kkredit/Senior_Design_Team_16/README.md

# senior-design-team-16
The code for my senior design project, GardeNet, an IoT garden watering automation system.
To anyone looking through the history, apologies for the poor workflow. Our team was learning how to use git along the way.
