kkredit/Senior_Design_Team_16/Team16Website/garden_net/gn_util/garden_info.txt

{"Garden":{"openZones":"3"},"Zone1":{"name":"Planter Boxes","weather":"Full","node":"1","valve":"1","openevents":"3"},"Zone2":{"name":"Planter Boxes 2","weather":"Partial","node":"1","valve":"2","openevents":"3"},"Zone3":{"name":"Field","weather":"None","node":"1","valve":"3","openevents":"3"},"Zone4":{"name":"New Zone","node":"3","valve":"4","weather":"None","openevents":"8"}}
