kkredit/Senior_Design_Team_16/Team16Website/Documents/OralPresentation3.pdf

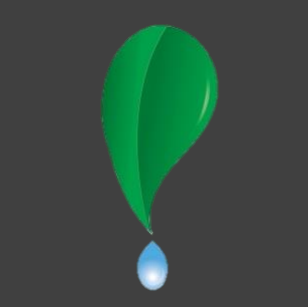
[picture p1: figure]

# GardeNet

# T EAM 1 6

# JOHN CONNELL, ANTHONY JIN, CHARLES KINGSTON, AND KEVIN KREDIT

# The Team

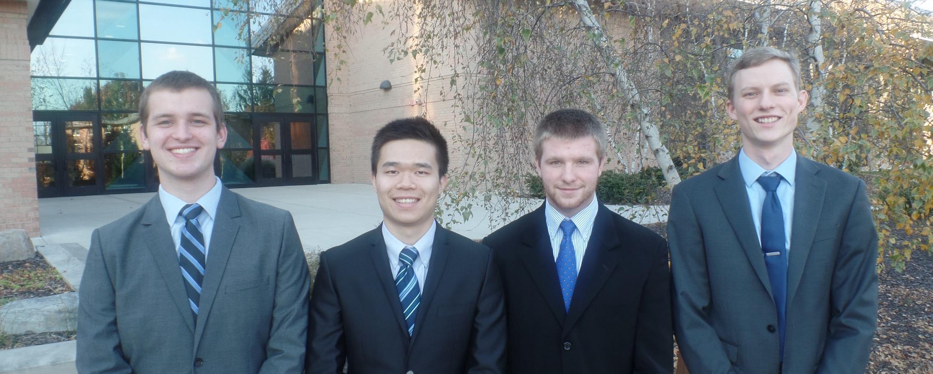
[picture p2: figure]

## John Connell | Anthony Jin | Charles Kingston | Kevin Kredit

# Overview

# ☐ The Project

# ☐ Design Decisions

# ☐ Project Highlights

# ☐ Current Status

The Project

# The Project

# The Problem

## ☐ Watering is a labor intensive venture ☐ Community gardens often have difficulties to get consistent volunteer help

# Our Solution

## ☐ Automate the watering process via

## ☐ 3G cellular network

## ☐ Internet-of-Things (IoT)

## ☐ Our main client is Caledonia Community Garden

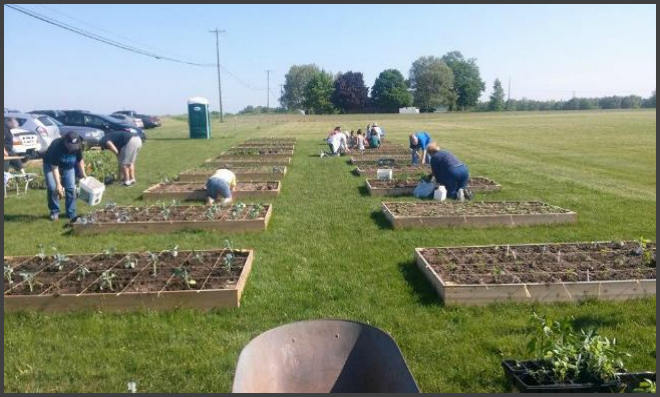
[picture p3: figure]

https://lintvwotv.files.wordpress.com/2014/06/maranda-caledonia-community-garden.jpg?w=650

## Caledonia Community Garden

The Project

# Our Design

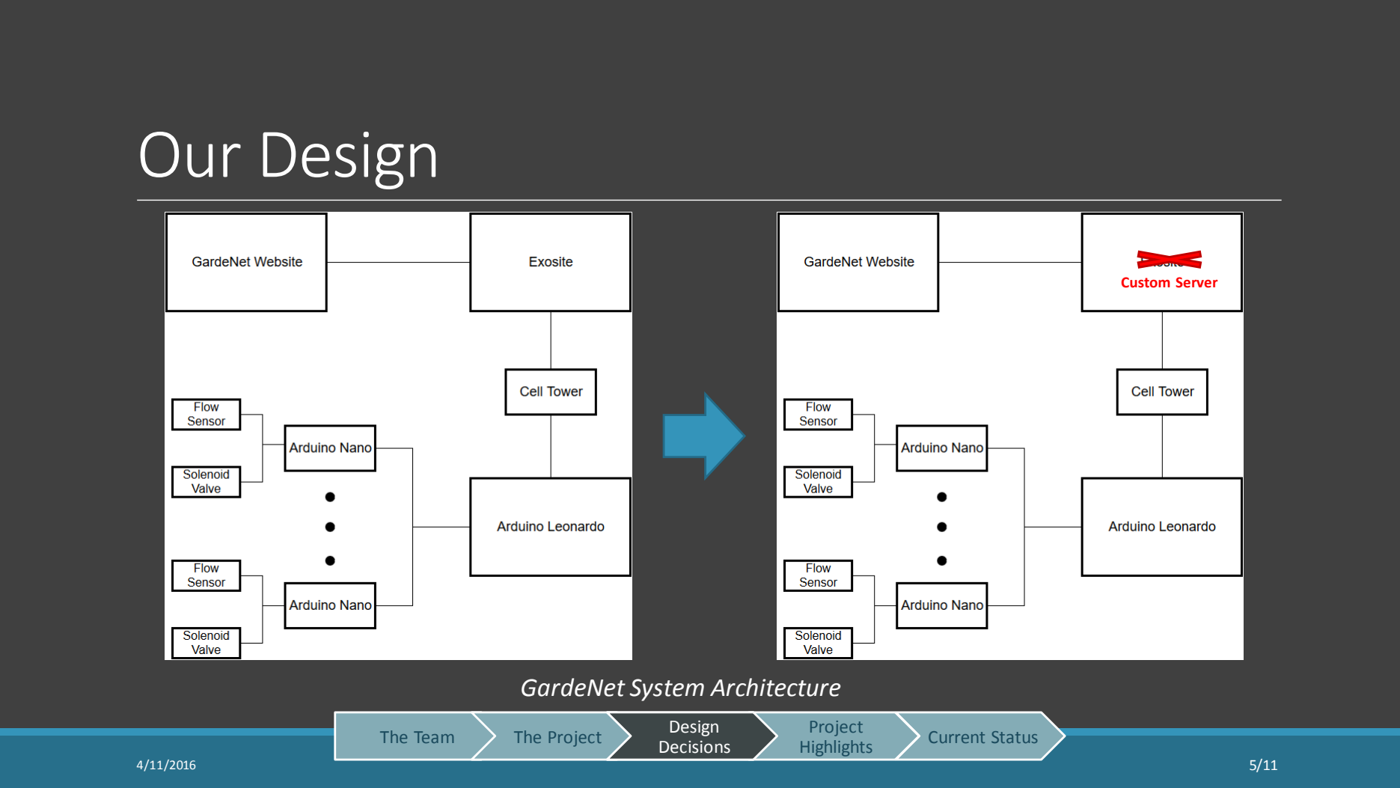
[picture p4: page 5]

Design
Decisions

## GardeNet System Architecture

Custom Server

# Hardware & Mesh Network

# ☐ Controlling valves ☐ Reading flow rates ☐ Communicating with the gateway ☐ Stability and PCB design

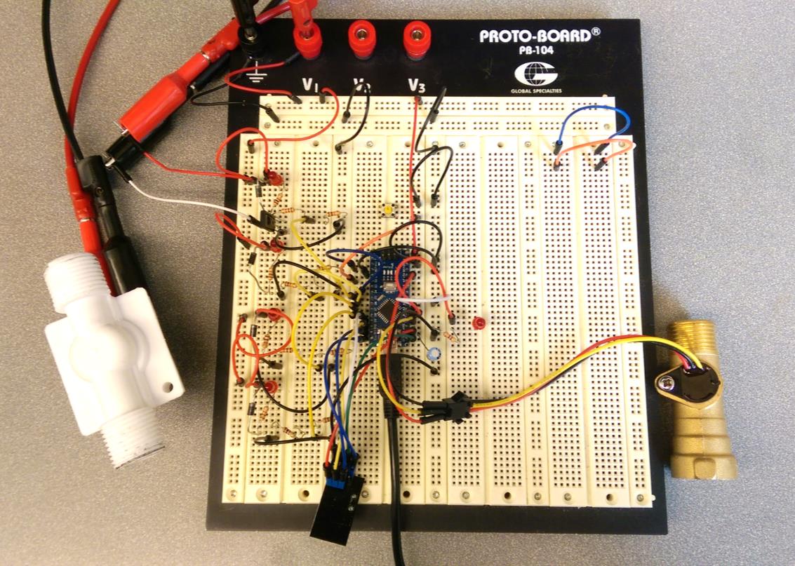
[picture p5: figure]

## The Node Breadboard

# Gateway & Arduino Shields

# ☐ Activated the 3G modem ☐ Added another shield ☐ Currently integrating 3G and radio communications

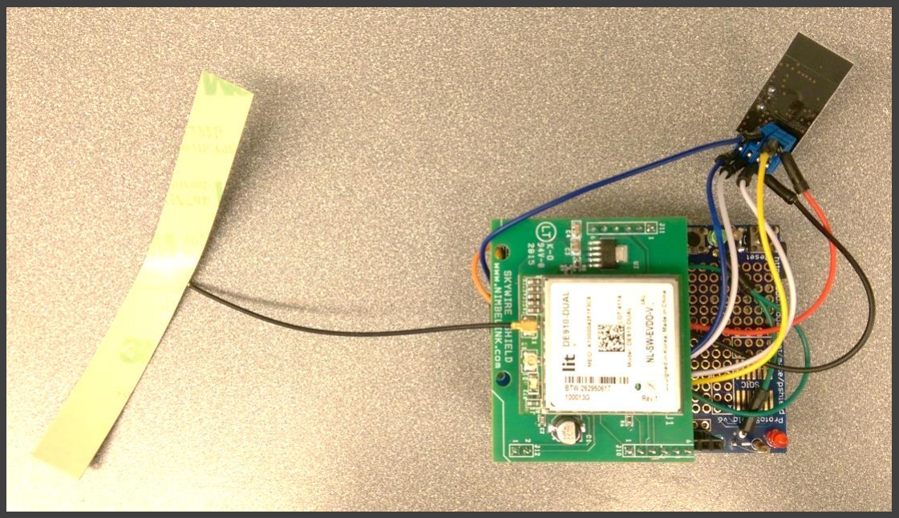
[picture p6: figure]
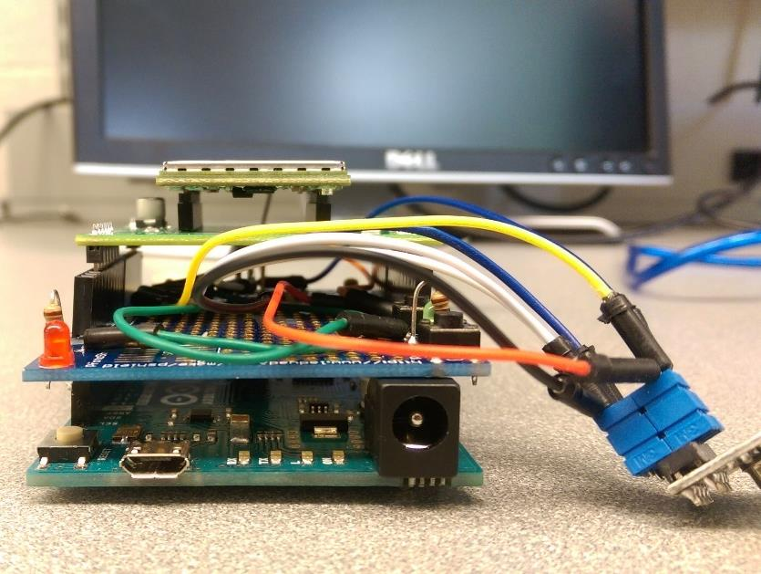
[picture p7: figure]

## The Gateway

# Server & Database

# ☐ Python scripts ☐ Hosted on a Raspberry Pi ☐ Interface & utilities ☐ Database

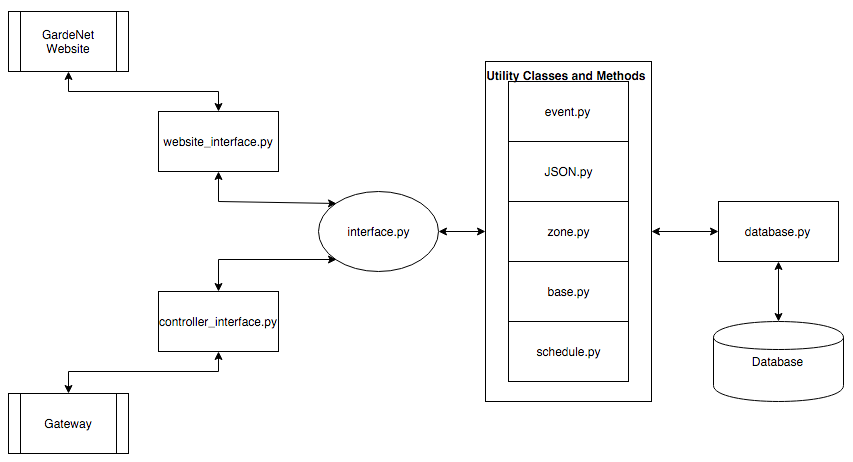
[picture p8: figure]

## GardeNet Server Architecture

# Website (gardenet.ddns.net)

# ☐ Schedules and switches ☐ Dynamically add zones and events ☐ Password protection ☐ “Live” on Raspberry Pi ☐ Dynamic DNS ☐ Future: Administrator View and Guest View

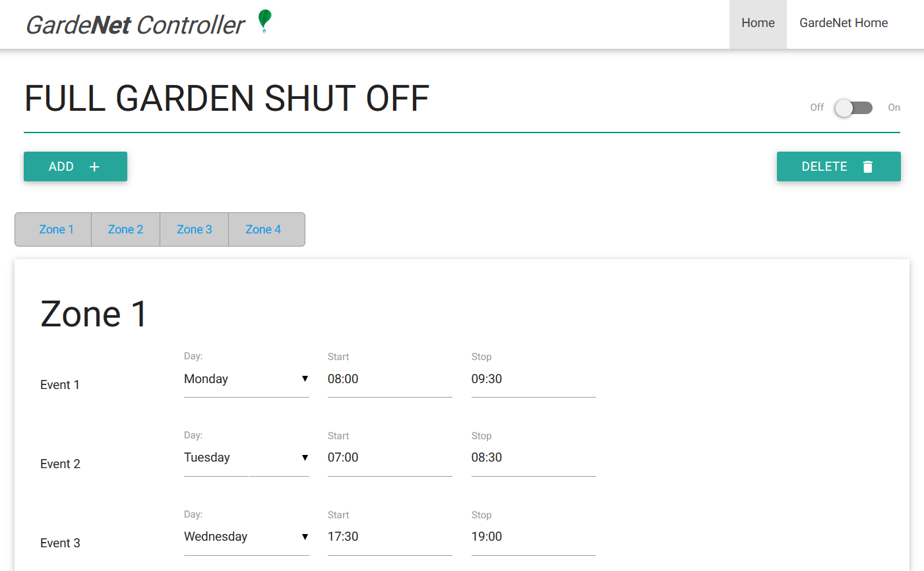
[picture p9: figure]

## GardeNet Controller

# Project Highlights

# Challenges

# ☐ Exosite vs. GardeNet server ☐ Budget & time constraints

# Opportunities

# ☐ Advice from experts ☐ Most important design norm: Trust

Project

# Current Status

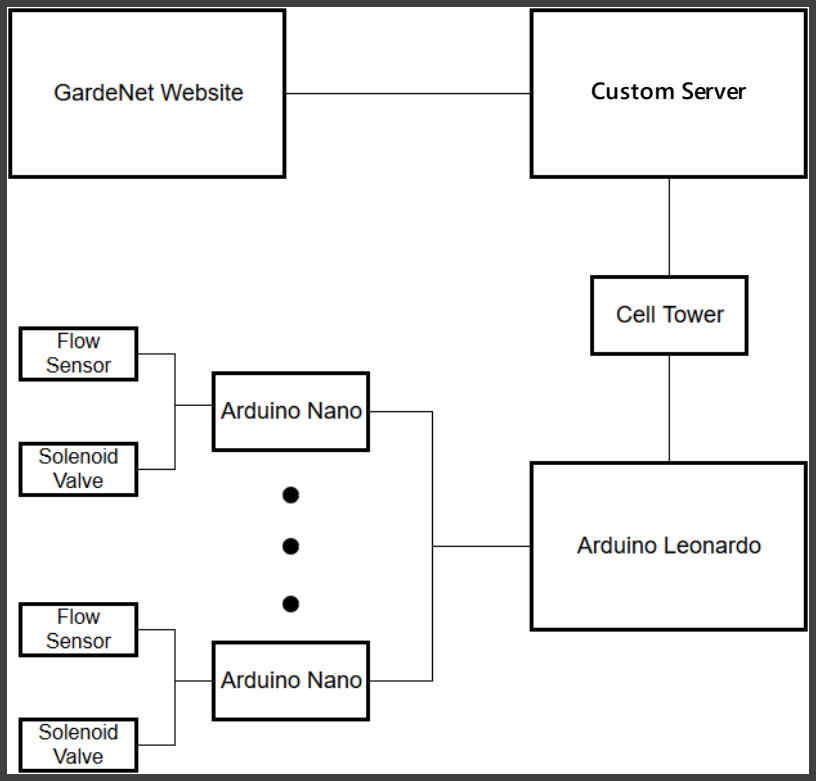
[picture p10: figure]
Custom Server

# ☐ Hardware & Mesh Network ☑

# ☐ Gateway

## ☐ Mesh network, 3G cell connection, internal timer ☑ ☐ Communication with server, scheduling algorithm ☒

## ☐ Server & Database

## ☐ Utilities and database ☑ ☐ Interfaces, process weather information ☒

# ☐ Website

## ☐ Basic UI and functionalities ☑ ☐ Dynamic zone size, message passing ☒

Current Status

4/11/2016

# Questions?
