kkredit/Senior_Design_Team_16/Team16Website/Documents/Team16FinalPresentation.pdf

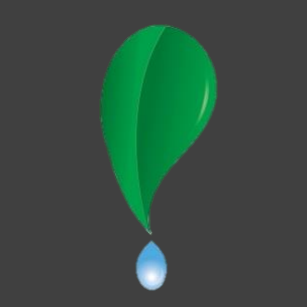
[picture p21: figure]

# GardeNet

### TEAM 16

### JOHN CONNELL, ANTHONY JIN, CHARLES KINGSTON, AND KEVIN KREDIT

# The Team


John Connell | Anthony Jin | Charles Kingston | Kevin Kredit

The Team | The Project | Design
Decisions | Reflections Project

# Overview

## ☐ The Project

## ☐ Design Decisions

## ☐ Project Highlights

## ☐ Reflections

The Project

The Team | The Project | Design

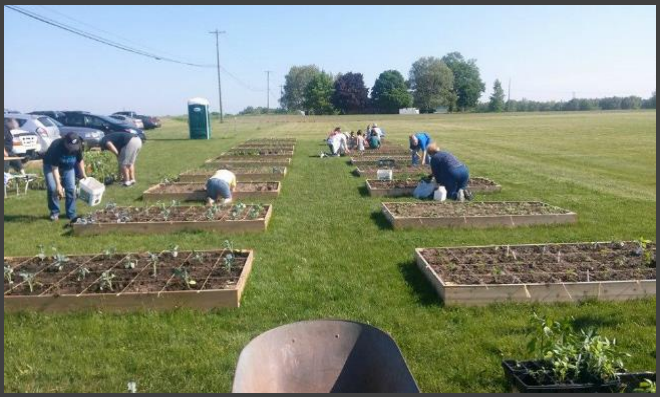
[picture p22: figure]

Decisions | Reflections Project

# The Project

### The Problem

☐ Watering is a labor intensive venture
☐ Community gardens often have difficulties to get consistent volunteer help

### Our Solution

☐ Automate the watering process via
☐ 3G cellular network
☐ Internet-of-Things (IoT)

### Target Market

☐ Urban farms to community and home gardens ☐ Our main client is Caledonia Community Garden https://lintvwotv.files.wordpress.com/2014/06/maranda-caledonia-community-garden.jpg?w=650

Caledonia Community Garden

The Project

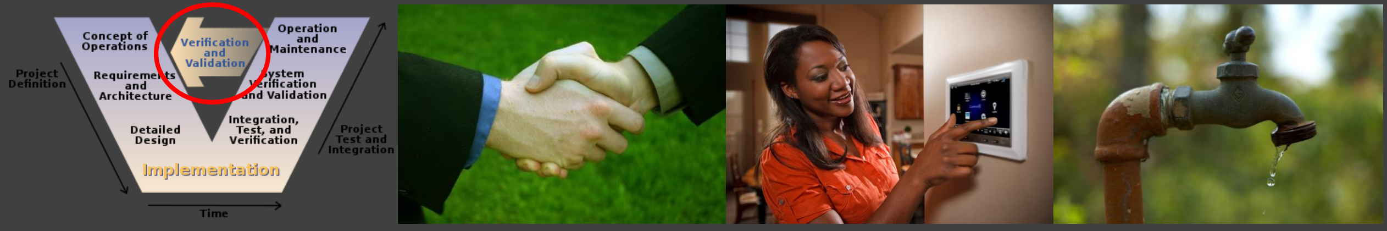
[picture p23: figure]

The Team | The Project | Design
Decisions | Reflections Project

# Design Norms

☐ Integrity | ☐ Trust | ☐ Humility | ☐ Stewardship

https://upload.wikimedia.org/wikipedia/commons/thumb/e/e8/Systems_Engineering_Process_II.svg/420px-Systems_Engineering_Process_II.svg.pnghttp://www.profitguide.com/w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

http://g4.imgdpreview.com/384DA42DD7B54A149394C67164F2AD16.jpg

The Project

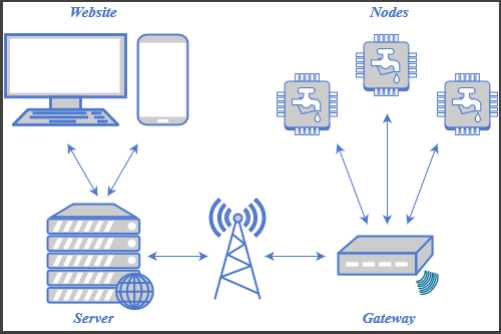
[picture p24: figure]

The Team | The Project | Design
Decisions | Reflections Project

# Our Design

Design
Decisions

Simplified GardeNet System Architecture

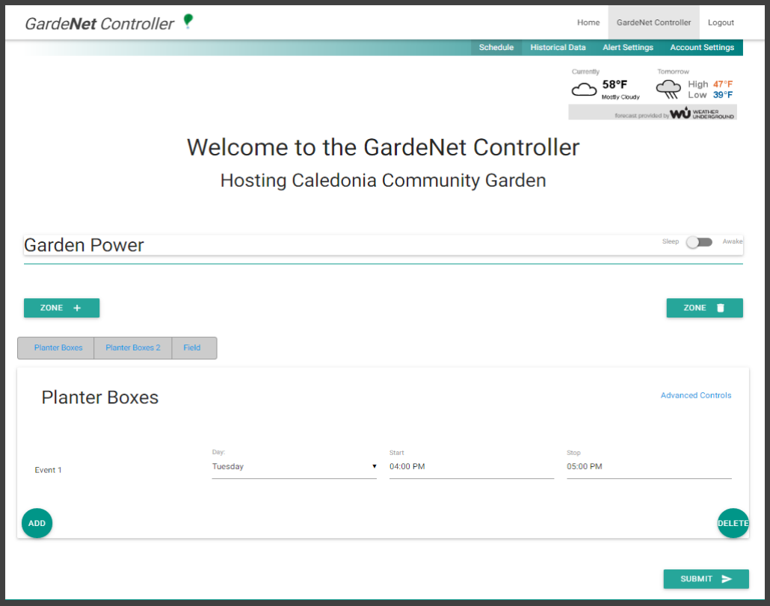
[picture p25: figure]

The Team | The Project | Design
Decisions | Reflections Project

# Website

Design
Decisions

### ☐ Platform: Apache web server on Raspberry Pi ☐ Features

☐ Dynamic scheduling
☐ Set weather sensitivity per zone
☐ “Public” and password
protected “Admin” views
☐ View historical data
☐ Modify alert and account settings

GardeNet Website

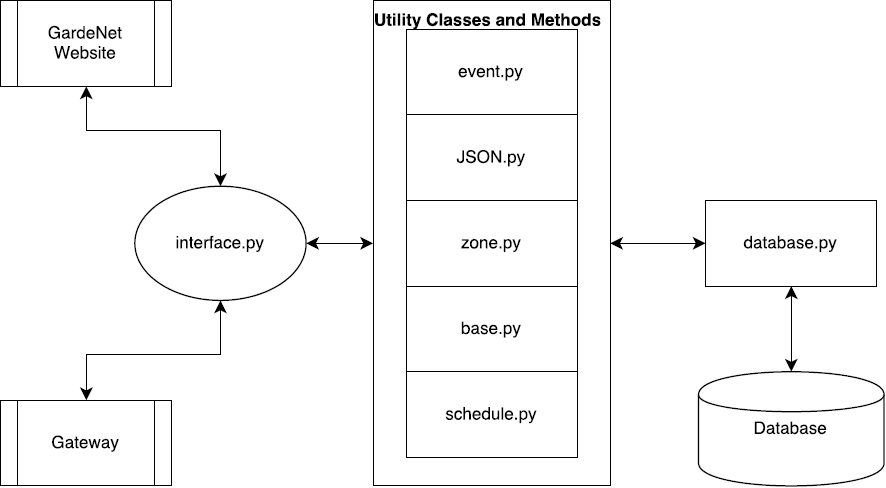
[picture p26: figure]

The Team | The Project | Design
Decisions | Reflections Project

# Server

### ☐ Platform: Python server on Raspberry Pi ☐ Communication: Internet sockets ☐ Controls

☐ Communication between the website and the gateway
☐ Historical data

### ☐ Monitors

☐ Weather
☐ Garden status, sends alerts

Design
Decisions

GardeNet Server Architecture

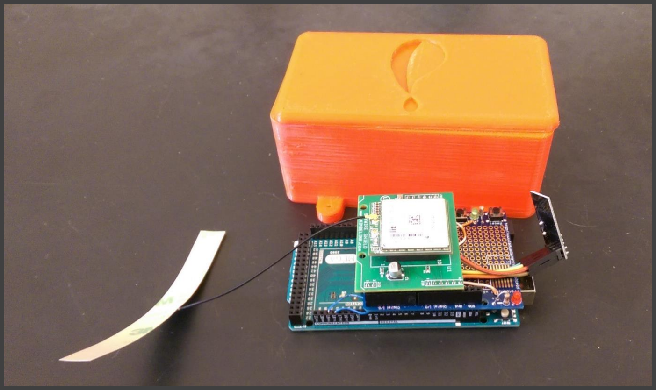
[picture p27: figure]

The Team | The Project | Design
Decisions | Reflections Project

# Gateway

### ☐ Platform: Arduino Leonardo / MEGA 2560 ☐ Communication

☐ 3G Modem
☐ RF24 radio

### ☐ Controls

☐ Nodes
☐ Alerts

### ☐ Monitors

☐ System feedback data

Design
Decisions

The Gateway

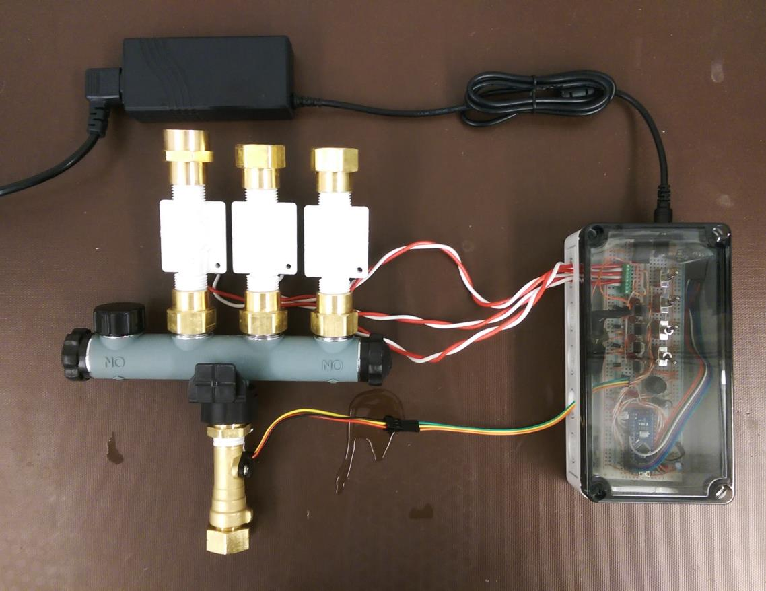
[picture p28: figure]

The Team | The Project | Design
Decisions | Reflections Project

# Node

### ☐ Platform: Arduino Nano ☐ Communication: RF24 radio ☐ Controls

☐ 4 valves
☐ 1 flow rate meter

### ☐ Monitors

☐ Input voltage level
☐ Flow states
☐ Communication link

### ☐ Modular

☐ Up to 16 nodes
☐ All programmed with same code

Design
Decisions

The Node

# Direct Control Video

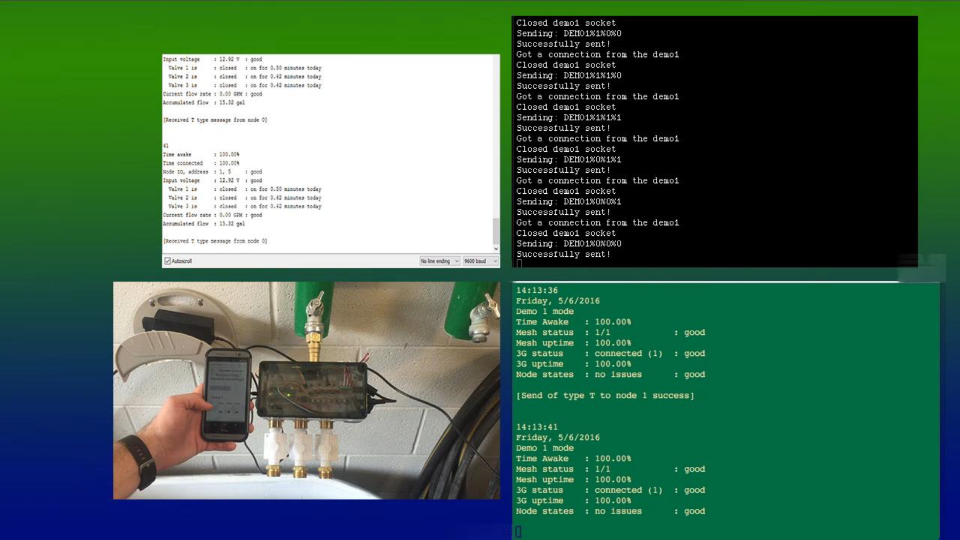
[picture p29: page 11]

The Team | The Project | Design
Decisions | Reflections Project

Project

# Schedule Video

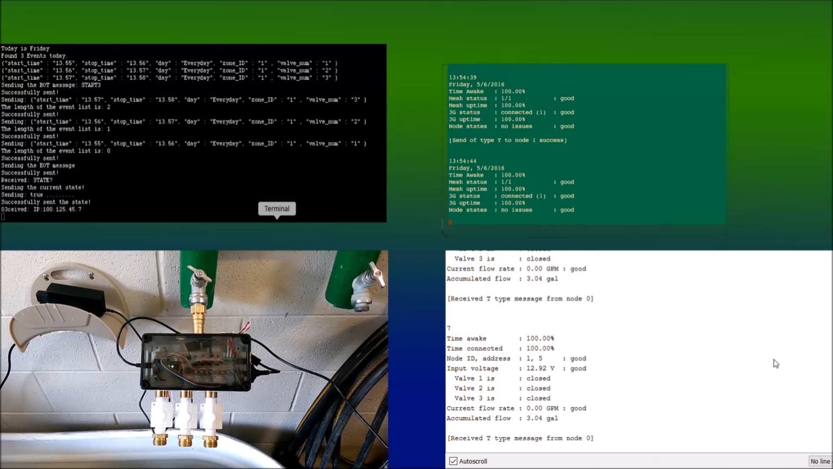
[picture p30: page 12]

The Team | The Project | Design
Decisions | Reflections Project

Project

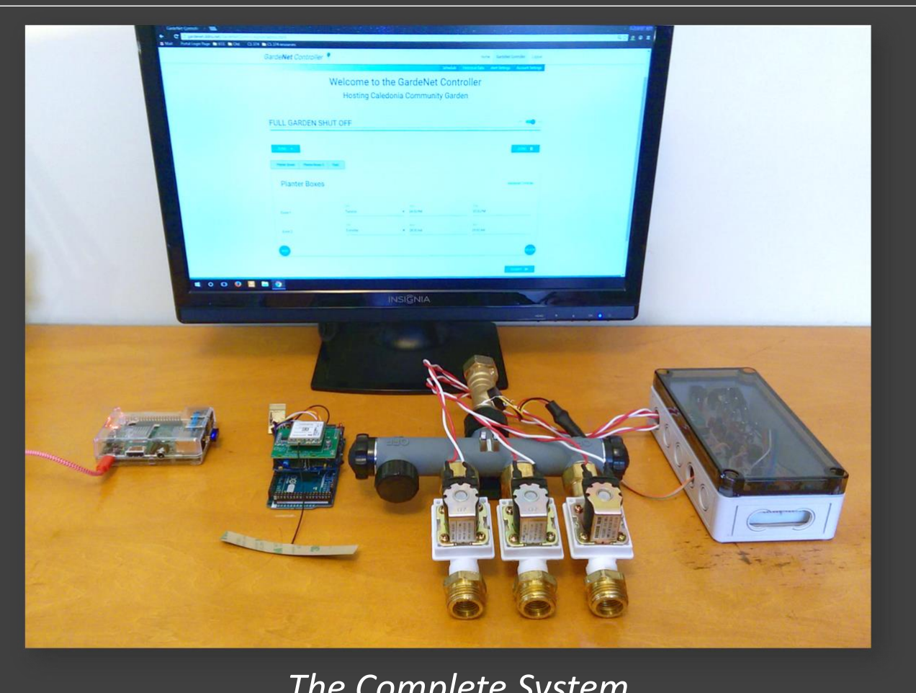
[picture p31: figure]

The Team | The Project | Design
Decisions | Reflections Project

# Project Highlights

## Challenges

### ☐ Seven programming languages ☐ Exosite vs. GardeNet server ☐ Reliability ☐ Budget and time constraints

## Opportunities

### ☐ Advice from experts ☐ Learning curve

Project

The Complete System

The Team | The Project | Design
Decisions | Reflections Project

# Assessment

Reflections

## What We Learned

### ☐ Systems design ☐ Web development ☐ Networking

## Future Work

### ☐ Better onsite control ☐ Onsite weather monitoring ☐ Control lights, outlets ☐ Dedicated mobile app ☐ Support multiple customers

The Complete System

The Team | The Project | Design
Decisions | Reflections Project

# Thanks

Reflections

Engineering Advisors ☐ Professor Mark Michmerhuizen ☐ Mentor Kurt Dykema ☐ Consultant Eric Walstra

Networking Advisors ☐ Professor Victor Norman ☐ Lab Administrator Chris Wieringa

Garden Managers ☐ David Benjamin of CCG ☐ Kyle Van Eerden of EDF

Engineering Support ☐ Bob DeKraker ☐ Phil Jasperse

5/17/2016

# Questions
