kkredit/Senior_Design_Team_16/Team16Website/garden_net/test/test_input.txt

{"zone1":
	{"event0":
		{"start_time" : "01:00", "stop_time" : "02:00", "day" : "Monday", "zone_ID" : "3" , "valve_num" : "1"},
	"event1":
		{"start_time" : "01:50", "stop_time" : "02:50", "day" : "Tuesday", "zone_ID" : "3" , "valve_num" : "1"},
	"event2":
		{"start_time" : "02:00", "stop_time" : "03.00", "day" : "Wednesday", "zone_ID" : "3", "valve_num" : "2"},
	"event3":
		{"start_time" : "03:00", "stop_time" : "04:00", "day" : "Thursday", "zone_ID" : "3" , "valve_num" : "1"}
    },
"zone2":
	{"event0":
		{"start_time" : "01:00", "stop_time" : "02:00", "day" : "Monday", "zone_ID" : "3" , "valve_num" : "1"},
	"event1":
		{"start_time" : "01:50", "stop_time" : "02:50", "day" : "Tuesday", "zone_ID" : "3" , "valve_num" : "2"},
	"event2":
		{"start_time" : "02:00", "stop_time" : "03.00", "day" : "Wednesday", "zone_ID" : "3", "valve_num" : "3"},
	"event3":
		{"start_time" : "03:00", "stop_time" : "04:00", "day" : "Thursday", "zone_ID" : "3" , "valve_num" : "1"}
    }
}
