kkredit/Senior_Design_Team_16/Team16Website/garden_net/test/test_output.txt

{"zone1":
	{"event0":
		{"start_time" : "1.0", "stop_time" : "2.0", "day" : "Monday", "zone_ID" : "1"},
	"event1":
		{"start_time" : "1.5", "stop_time" : "2.5", "day" : "Tuesday", "zone_ID" : "1"},
	"event2":
		{"start_time" : "2.0", "stop_time" : "3.0", "day" : "Wednesday", "zone_ID" : "1"},
	"event3":
		{"start_time" : "3.0", "stop_time" : "4.0", "day" : "Thursday", "zone_ID" : "1"}
	},
"zone2":
	{"event0":
		{"start_time" : "1.0", "stop_time" : "2.0", "day" : "Monday", "zone_ID" : "2"},
	"event1":
		{"start_time" : "1.5", "stop_time" : "2.5", "day" : "Tuesday", "zone_ID" : "2"},
	"event2":
		{"start_time" : "2.0", "stop_time" : "3.0", "day" : "Wednesday", "zone_ID" : "2"},
	"event3":
		{"start_time" : "3.0", "stop_time" : "4.0", "day" : "Thursday", "zone_ID" : "2"}
	},
"zone3":
	{"event0":
		{"start_time" : "3.0", "stop_time" : "4.0", "day" : "Tuesday", "zone_ID" : "3"},
	"event1":
		{"start_time" : "2.0", "stop_time" : "3.0", "day" : "Thursday", "zone_ID" : "3"},
	"event2":
		{"start_time" : "1.5", "stop_time" : "2.5", "day" : "Friday", "zone_ID" : "3"},
	"event3":
		{"start_time" : "1.0", "stop_time" : "2.0", "day" : "Saturday", "zone_ID" : "3"}
	}
}
