kkredit/Senior_Design_Team_16/Team16Website/GardeNetControl/history.html

###### Radio Network Percent Uptime: %

###### 3G Modem Percent Uptime: %

##### Company Bio

We are a team of college students working on this project for our Senior Design Project at Calvin College. Feel free to email us with any questions. Any help would also be greatly appreciated.

##### Gardens

- Caledonia Community Garden (http://caledoniacommunitygarden.org/)
- Eighth Day Farm (http://www.eighthdayfarm.org/)

##### Connect

- John Connell
- Anthony Jin
- Charles Kingston
- Kevin Kredit

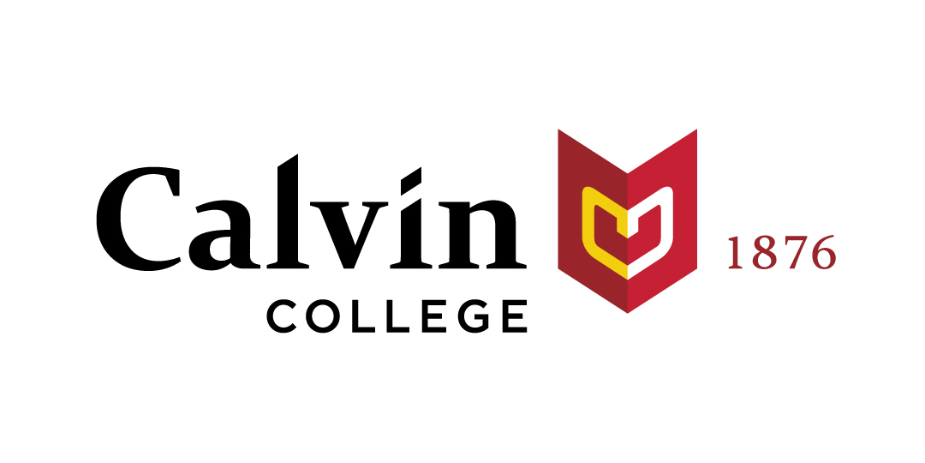
[picture p35: Team16Website/photos/CalvinLogo.jpg]
Calvin logo
 (http://www.calvin.edu)

Website by John Connell made with Materialize (http://materializecss.com) secrets are best kept by friends (http://i.imgur.com/UyDbQ7S.gif)
