kkredit/Senior_Design_Team_16/_TestFiles/RadioWork/RF24Mesh_Example_Master/RF24Mesh_Example_Master.ino

 
 
 /** RF24Mesh_Example_Master.ino by TMRh20
  * 
  *
  * This example sketch shows how to manually configure a node via RF24Mesh as a master node, which
  * will receive all data from sensor nodes.
  *
  * The nodes can change physical or logical position in the network, and reconnect through different
  * routing nodes as requiLEDR. The master node manages the address assignments for the individual nodes
  * in a manner similar to DHCP.
  *
  */
  
  
#include "RF24Network.h"
#include "RF24.h"
#include "RF24Mesh.h"
#include <SPI.h>
//Include eeprom.h for AVR (Uno, Nano) etc. except ATTiny
#include <EEPROM.h>
#include <TimerOne.h>

/***** Configure the chosen CE,CS pins *****/
RF24 radio(9,10);
RF24Network network(radio);
RF24Mesh mesh(radio,network);

uint32_t displayTimer = 0;
int printcount = 0;

#define BUTTON  3
#define LEDR    4
#define LEDG    5
#define LEDY    6

bool hadButtonPress = false;
bool LEDYstate = false;

void setup() {
  pinMode(BUTTON, INPUT_PULLUP);
  pinMode(LEDR, OUTPUT);
  pinMode(LEDG, OUTPUT);
  pinMode(LEDY, OUTPUT);
  //while(BUTTON); /////////// wait for a button press to continue, allowing for user to setup terminal
  delay(5000);
  attachInterrupt(digitalPinToInterrupt(BUTTON), handleButton, FALLING);  
  digitalWrite(LEDR, LOW);
  digitalWrite(LEDG, LOW);
  digitalWrite(LEDY, LOW);

  digitalWrite(LEDR, HIGH);
  delay(500);
  digitalWrite(LEDR, LOW);
  digitalWrite(LEDY, HIGH);
  
  Serial.begin(9600);
  //radio.setPALevel(RF24_PA_LOW);
  // Set the nodeID to 0 for the master node
  mesh.setNodeID(0);
  Serial.println(mesh.getNodeID());
  // Connect to the mesh
  Serial.print("Output of mesh.begin(): ");
  Serial.println(mesh.begin(12, RF24_250KBPS, 2000));
  //mesh.requestAddress(0);
  mesh.setAddress('0'-48, 1);

  digitalWrite(LEDY, LOW);
  digitalWrite(LEDR, HIGH);
  delay(250);
  digitalWrite(LEDR, LOW);
  delay(250);
  digitalWrite(LEDR, HIGH);
  delay(250);
  digitalWrite(LEDR, LOW);

  Timer1.initialize(5000000);
  Timer1.attachInterrupt(printStatus);
}

/*
 * Regardless of current state, send message to other to turn on LEDY
 */
void handleButton(){
    hadButtonPress = true;
    Serial.println(F("Deteceted Button Press"));
}

void printStatus(){
  Serial.println("");
  Serial.println(printcount++);
  Serial.print("\nMy ID:      ");
  Serial.println(mesh.getNodeID());
  Serial.print("My address: ");
  Serial.println(mesh.getAddress(0));
  Serial.println(" ");
  Serial.println(F("********Assigned Addresses********"));
  for(int i=0; i<mesh.addrListTop; i++){
    Serial.print("NodeID: ");
    Serial.print(mesh.addrList[i].nodeID);
    Serial.print(" RF24Network Address: 0");
    Serial.println(mesh.addrList[i].address,OCT);
 }
  Serial.println(F("**********************************"));
}

void loop() {    

  // Call mesh.update to keep the network updated
  mesh.update();
  
  // In addition, keep the 'DHCP service' running on the master node so addresses will
  // be assigned to the sensor nodes
  mesh.DHCP();
  
  
  // Check for incoming data from the sensors
  if(network.available()){
    RF24NetworkHeader header;
    network.peek(header);
    
    uint32_t dat=0;
    switch(header.type){
      // Display the incoming millis() values from the sensor nodes
//      case 'M': 
//        digitalWrite(LEDR, HIGH);
//        delay(1000);
//        digitalWrite(LEDR, LOW);
//        network.read(header,&dat,sizeof(dat)); 
//        Serial.println(dat); 
//        break;
      case 'B':
        LEDYstate = !LEDYstate;
        digitalWrite(LEDY,LEDYstate);
        Serial.println(F("Toggling LEDY"));
        network.read(header,&dat,sizeof(dat)); 
        break;
      default: 
        network.read(header,0,0); 
        Serial.println("Message on network, but not reading it");
        break;
    }
  }
  
  if(millis() - displayTimer > 5000){
    displayTimer = millis();
    Serial.println(" ");
    Serial.println(F("********Assigned Addresses********"));
     for(int i=0; i<mesh.addrListTop; i++){
       Serial.print("NodeID: ");
       Serial.print(mesh.addrList[i].nodeID);
       Serial.print(" RF24Network Address: 0");
       Serial.println(mesh.addrList[i].address,OCT);
     }
    Serial.println(F("**********************************"));
  }
}
