kkredit/Senior_Design_Team_16/(commit log)

2015-12-09 Updates made when trying to make the samples work
2015-12-09 Updated slave and master to flash the red LED, sends a message when the button is pressed, and toggles the yellow LED when the button on the other is pressed (does not work yet)
    [rf24-getstarted-master.ino.ino, rf24-getstarted-slave.ino.ino]
2015-12-10 just a slight update to the master. it uses a "detect button" serial print in the ISR and then serial prints "sending...." when it actually attempts to write
2015-12-10 Slave code update--added separate "detect button" to "sent LEDY message"
2016-01-13 Trivial changes to rf24-slave code Added button functionality to rf24mesh_example It works now!!
2016-01-13 RF24 Mesh Example master code is working with added receive button press functionality as well as add the handleButtonPress() fund
2016-01-13 Added the masters code in its own folder. Master also has capability to read a flow sensor now.
2016-01-13 Deleted flow rate sensor code and added a message to look for a float of liters
2016-01-13 Added node.ino file and integrated flow rate sensor code into it
2016-01-26 changed to switch case statements and removed flow sensor code cause not needed
2016-01-27 Removed errors from Node code to get it to work with the master; basic functionality is working
    [node.ino]
2016-01-31 Added comments; modified safeMeshWrite to automatically retry sending after 50ms if the send failed but are connected
    [node.ino]
2016-02-05 Added RETRY_PERIOD to set retry period on failed messages Changed get flow rate to return rate in GPM rather than accumulated liters
    [node.ino]
2016-02-06 Added header.from_node serial prints to see if that can help us determine the sender of given messages
2016-02-06 Master now compiles; added print command to test header.from_node
2016-02-06 Master now prints GPM instead of liters Node now reports GPM when button is pressed
2016-02-06 Master buttonpress now changes valve state Misc. changes to node
2016-02-08 Added settings.h, SharedFunctions.h, and SharedFunctions.cpp settings.h is a collection of #defines that sets mesh settings, useful for both master and nodes SharedFunctions.h/cpp is intended to be a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
2016-02-10 Node now actually controls valve; VALVE_0 = pin A4
2016-02-10 Added some Serial.print commands to make it clearer what it's doing; confirmed works at controlling the valve, though testing was difficult because the master seems buggy (freezes, doesn't always res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
    [node.ino]
2016-02-16 Node now uses only LEDR; valve state shown is shown by LED directly connected to valve circuit
2016-02-23 Removed a print statement from the test_database.py
2016-02-29 need to work on how I will be grabbing the needed data from the database and packing it into JSON to be sent. Switching gears to server and socket scripts.
2016-03-03 Committing to switch Branches
2016-03-03 Updated a for more aestetic print out to the console in both server and client for controller
2016-03-03 Small change to the controller interface print statement
2016-03-03 added a print statement
2016-03-05 Updates whole website to match what's currently on the Raspberry Pi
2016-03-24 Revert "Updated schedule class and master code. Now schedule class only uses int type and master has some 3G modem and schedule stuff."
    This reverts commit 151f234cc53c607d945d9e598e11459982f2bfe0.
    [RF24Mesh_Example.ino, RF24Mesh_Example_Master.ino, Timer.ino]
2016-04-05 Modem: fixed connection issue with server, JSON parsing is almost done
    [Modem.ino, Timer.ino, master.ino]
2016-04-11 Added valve_num
2016-04-12 Fixed redundant schedule class include issue.
    [Modem.ino, Timer.ino]
2016-04-13 Master_No_3G updated for my own testing node.ino sends node status when opens/closes valves Schedule.h file now doesn't have full shouldValveBeOpen function
    [Master_No_3G.ino, node.ino]
2016-04-13 Several fixes: Internal timer - now synchronizes with NIST UTC time and adjust to EST time Modem - now detects 3G connection status based on modem response JSON parsing - (seems to) fix incomplete JS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
    [Timer.ino, master.ino]
2016-04-13 Master has updates developed from Master_No_3G Master_No_3G implements schedule flawlessly, but has some mesh stability issues node.ino has changes in the way it responds to node requests; will likel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
    [Master_No_3G.ino, SharedDefinitions.h, master.ino, node.ino]
2016-04-18 Fixed create schedule event code in master; also added an everyday option in the weekday decoder function. Started brainstorming the alert engine.
    [SharedDefinitions.h, master.ino]
2016-04-18 master.ino has updated comments master.ino now correctly recognizes downed nodes and adds them back when possible node.ino adds CONNECTION_TEST_H type message SharedDefinitions.h adds CONNECTION_TEST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
    [SharedDefinitions.h, master.ino, node.ino]
2016-04-20 Master updated to track the stats
2016-04-20 Master updated to successfully track stats, also has isNewDay() function, to be called once per day Node tracks mesh uptimes, successfully tracks daily stats SharedDefinitions updated with new elemen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
2016-04-20 Started alert engine; first fix to 3G socket dial issue.
    [Modem.ino, alert.ino, master.ino]
2016-04-23 Updated master code: 3G connection problems are mostly solved, and the alert engine is mostly done. Started working on special garden operations such as turn the whole garden on/off.
    [Modem.ino, master.ino]
2016-04-23 Updated the way printStatus looks
2016-04-24 Moved master.ino into new folder master.ino now (1) handles all alert scenarios properly and without repeat alerts (2) handles the new day sequence fully (3) handles garden on/off correctly node.ino 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
    [SharedDefinitions.h, master.ino, node.ino]
2016-04-24 Fixed setTime back to normal; modified it for testing
    [master.ino]
2016-04-28 Major overhaul for modem response decoding. Fixed major issue with JSON parsing.
    [Modem.ino, master.ino]
2016-04-28 Node prints a few things nicer and resolves low voltage bugs. Still checks voltage when valves are open, and goes to sleep if gets low voltage SharedDefs adds OK_VIN_DROP_PER_NODE, used in the above
    [SharedDefinitions.h, node.ino]
2016-04-28 Master now doesn't send mesh alert unless has been around for TIME_TILL_MESH_ERR seconds
    [SharedDefinitions.h, master.ino, node.ino]
2016-04-29 Master now prints its status more cleanly
2016-04-30 The gateway now sends server and SMS alerts that differentiate between new and resolved alerts. Updated protocol for communicating with the server
    [SharedDefinitions.h, master.ino]
2016-04-30 Gateway false alarms resolved
    [SharedDefinitions.h, master.ino]
2016-05-01 Resolved merge conflict from last merge
    [master.ino]
2016-05-03 Fixed node voltage issue
    [SharedDefinitions.h, node.ino]
2016-05-03 KEVIN: 3G fixes plus Kevin's change
    [master.ino]
2016-05-07 Flow rate and false positives fixed
    [node.ino]
2016-05-10 Fixed JSON parsing issues and added error checking routine for incomplete JSON strings. The gateway code is mostly done.
    [SharedDefinitions.h, master.ino]
2016-05-11 Fixed issues with garden setup routine. Gateway now attempt to reconnect to the server every minute if connection is down.
    [SharedDefinitions.h, master.ino]
2016-05-18 Fixed accelerated time for testing
    [Gateway.ino]
